ottermarine/pypilot_controller/pypilot_controller.kicad_pcb

## KiCad design pypilot_controller.kicad_pcb (2025-01-22)

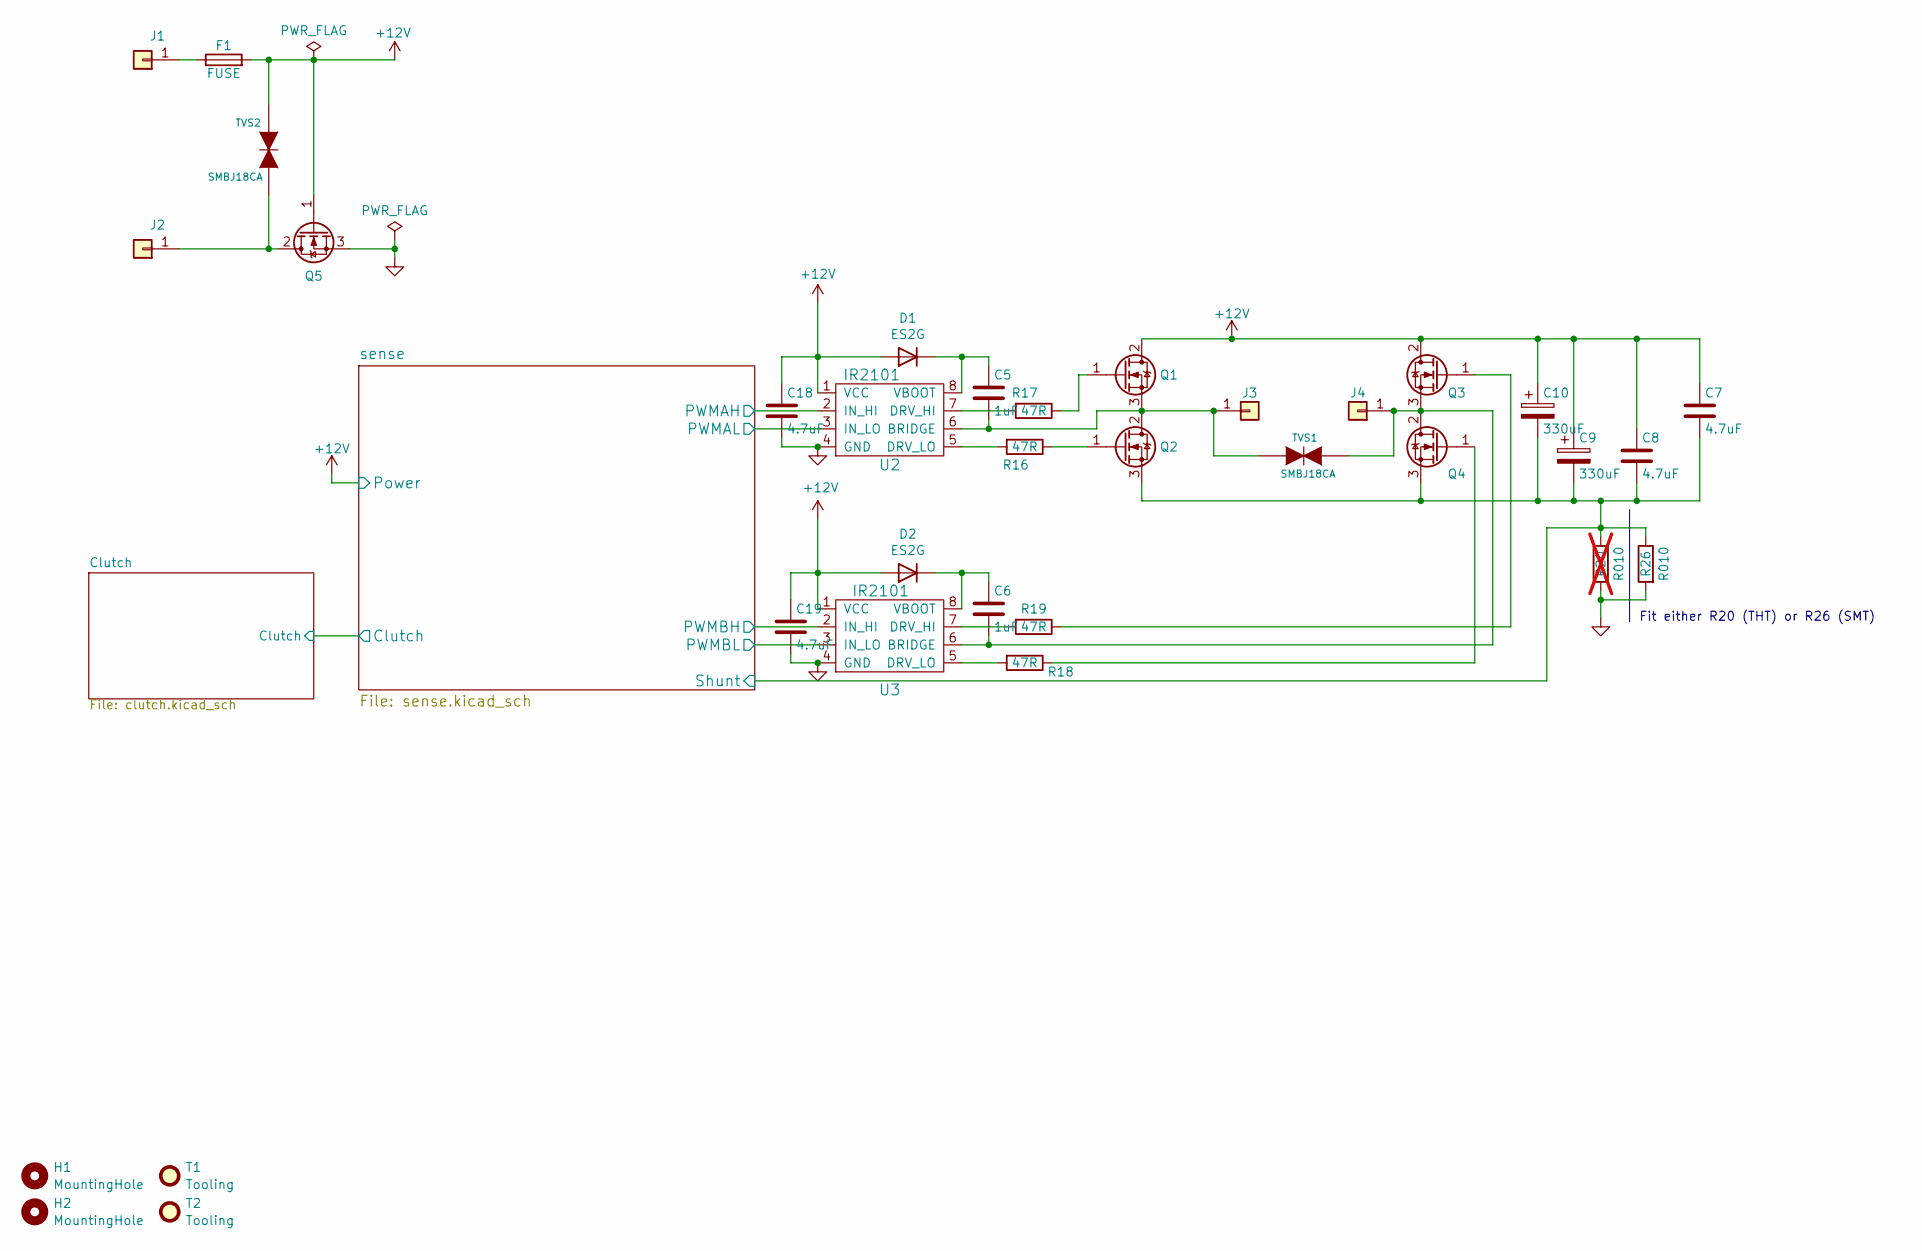
[picture p1: schematic pypilot_controller.kicad_sch]

Parts:
C5, C6: 1uF; C_0805_2012Metric; LCSC C28323
C7, C8, C18, C19: 4.7uF; C_1206_3216Metric; LCSC C29823
C9, C10: 330uF; CP_Radial_D10.0mm_P5.00mm; LCSC C357629
D1, D2: ES2G; D_SMA; LCSC C2848675
F1: FUSE; FUSE-TH_BX503-35; LCSC C2935871
H1, H2: MountingHole; MountingHole_2.5mm
J1: power+; CONN-TH_T44001; LCSC C481447
J2: power-; CONN-TH_T44001; LCSC C481447
J3: Motor A; CONN-TH_T44001; LCSC C481447
J4: Motor B; CONN-TH_T44001; LCSC C481447
Q1, Q2, Q3, Q4, Q5: IRFR7440; TO-252-2-reduced-paste; LCSC C97244
R16, R17, R18, R19: 47R; R_0805_2012Metric; LCSC C17714
R20: R010; R_Axial_DIN0207_L6.3mm_D2.5mm_P15.24mm_Horizontal; not fitted
R26: R010; R_2512_6332Metric; LCSC C105366
T1, T2: Tooling; JLC_Tooling_Hole
TVS1, TVS2: SMBJ18CA; D_SMB_TVS; LCSC C83327
U2, U3: IR2101; SOIC-8_3.9x4.9mm_P1.27mm; LCSC C2956

Connections:
+12V: C7.1, C8.1, C9.1, C10.1, C18.1, C19.1, D1.2 (A), D2.2 (A), F1.2, Q1.2 (D), Q3.2 (D), Q5.1 (G), TVS2.2 (K), U2.1 (VCC), U3.1 (VCC); also elsewhere on the board
/sense/PWMAH: U2.2 (IN_HI); also elsewhere on the board
/sense/PWMAL: U2.3 (IN_LO); also elsewhere on the board
/sense/PWMBH: U3.2 (IN_HI); also elsewhere on the board
/sense/PWMBL: U3.3 (IN_LO); also elsewhere on the board
/sense/Shunt: C7.2, C8.2, C9.2, C10.2, Q2.3 (S), Q4.3 (S), R20.1, R26.1; also elsewhere on the board
GND: C18.2, C19.2, Q5.3 (S), R20.2, R26.2, U2.4 (GND), U3.4 (GND); also elsewhere on the board
unnamed: C5.1, D1.1 (K), U2.8 (VBOOT)
unnamed: C6.1, D2.1 (K), U3.8 (VBOOT)
unnamed: F1.1, J1.1
unnamed: J2.1, Q5.2 (D), TVS2.1 (A)
unnamed: C5.2, J3.1, Q1.3 (S), Q2.2 (D), TVS1.2 (K), U2.6 (BRIDGE)
unnamed: C6.2, J4.1, Q3.3 (S), Q4.2 (D), TVS1.1 (A), U3.6 (BRIDGE)
unnamed: Q1.1 (G), R17.1
unnamed: Q2.1 (G), R16.1
unnamed: Q3.1 (G), R19.1
unnamed: Q4.1 (G), R18.1
unnamed: R17.2, U2.7 (DRV_HI)
unnamed: R16.2, U2.5 (DRV_LO)
unnamed: R19.2, U3.7 (DRV_HI)
unnamed: R18.2, U3.5 (DRV_LO)

Notes on the sheet:
Fit either R20 (THT) or R26 (SMT)

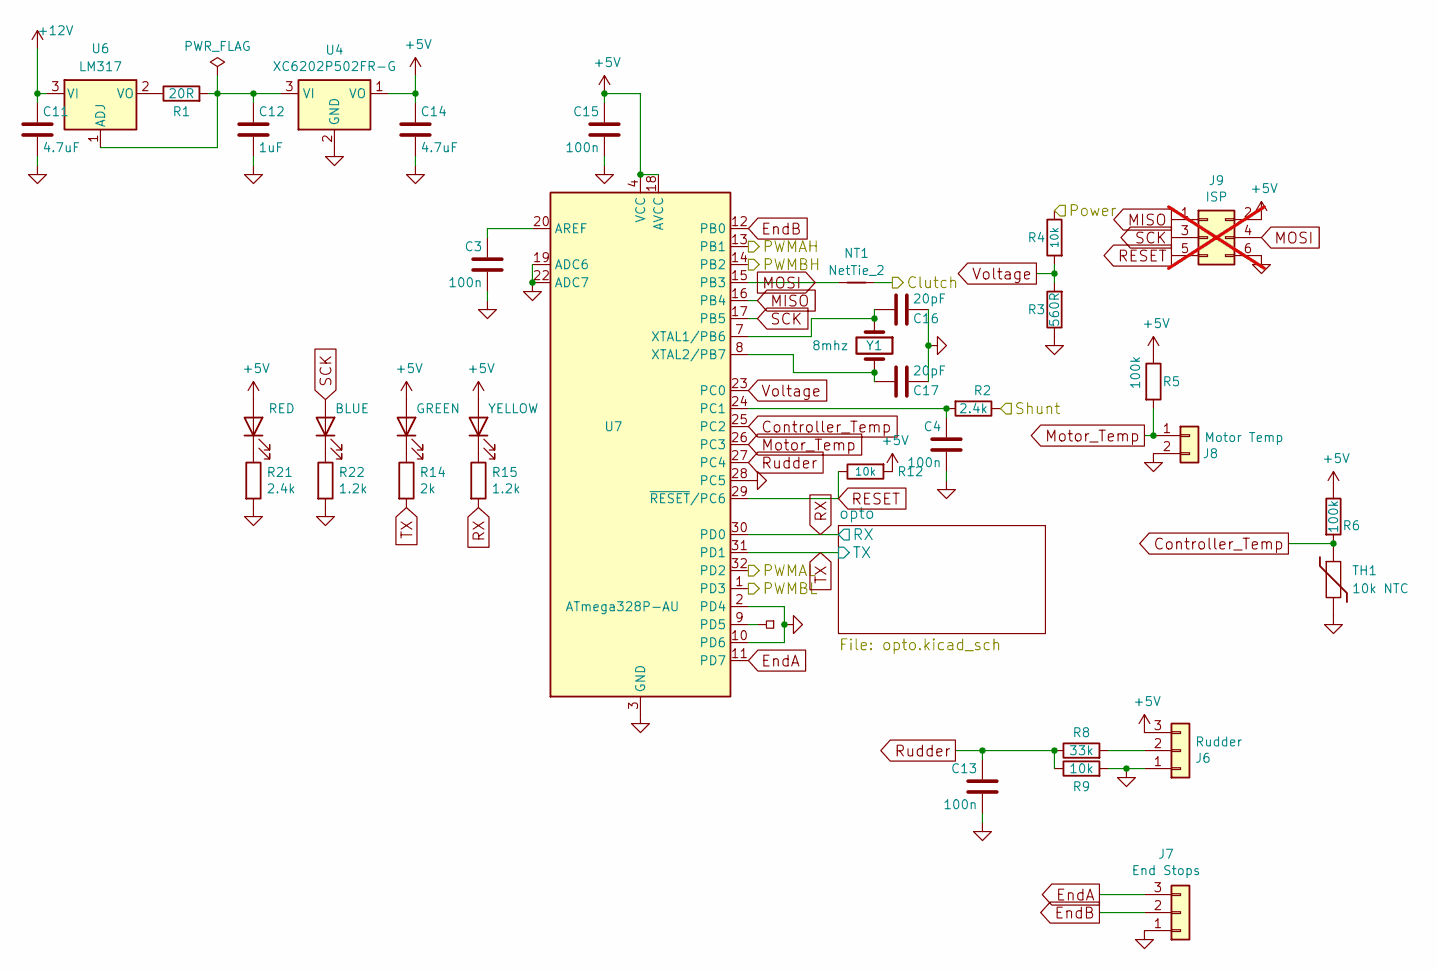
[picture p2: schematic sense.kicad_sch]

Parts:
C3, C4, C13, C15: 100n; C_0805_2012Metric; LCSC C49678
C11, C14: 4.7uF; C_1206_3216Metric; LCSC C29823
C12: 1uF; C_0805_2012Metric; LCSC C28323
C16, C17: 20pF; C_0805_2012Metric; LCSC C1798
J6: Rudder; PinHeader_1x03_P2.54mm_Vertical; LCSC C19190477
J7: End Stops; PinHeader_1x03_P2.54mm_Vertical; LCSC C19190477
J8: Motor Temp; PinHeader_1x02_P2.54mm_Vertical; LCSC C7494857
J9: ISP; PinHeader_2x03_P2.54mm_Vertical_SMD; LCSC C192301; not fitted
JP1: PCB_Pin_Breakout; TestPoint_Pad_1.0mm
LED1: RED; LED_0805_2012Metric; LCSC C84256
LED2: BLUE; LED_0603_1608Metric; LCSC C2290
LED3: GREEN; LED_0805_2012Metric; LCSC C2297
LED4: YELLOW; LED_0805_2012Metric; LCSC C2296
NT1: NetTie_2; NetTie-2_SMD_Pad0.5mm
R1: 20R; R_1206_3216Metric; LCSC C17955
R2, R21: 2.4k; R_0805_2012Metric; LCSC C17526
R3: 560R; R_0805_2012Metric; LCSC C28636
R4, R9, R12: 10k; R_0805_2012Metric; LCSC C17414
R5, R6: 100k; R_0805_2012Metric; LCSC C149504
R8: 33k; R_0805_2012Metric; LCSC C17633
R14: 2k; R_0805_2012Metric; LCSC C17604
R15, R22: 1.2k; R_0805_2012Metric; LCSC C17379
TH1: 10k NTC; R_0805_2012Metric; LCSC C72672
U4: XC6202P502FR-G; SOT-223-3_TabPin2; LCSC C725695
U6: LM317; TO-252-2-reduced-paste; LCSC C68136
U7: ATmega328P-AU; TQFP-32_7x7mm_P0.8mm; LCSC C14877
Y1: 8mhz; Crystal_SMD_5032-2Pin_5.0x3.2mm; LCSC C115962

Connections:
+5V: C14.1, C15.1, J6.3, J9.2, LED1.2 (A), LED3.2 (A), LED4.2 (A), R5.1, R6.1, R12.2, U4.1 (VO), U7.4 (VCC), U7.6 (VCC), U7.18 (AVCC); also elsewhere on the board
+12V: C11.1, R4.1, U6.3 (VI); also elsewhere on the board
/Clutch/Clutch: NT1.2; also elsewhere on the board
/sense/PWMAH: U7.13 (PB1); also elsewhere on the board
/sense/PWMAL: U7.32 (PD2); also elsewhere on the board
/sense/PWMBH: U7.14 (PB2); also elsewhere on the board
/sense/PWMBL: U7.1 (PD3); also elsewhere on the board
/sense/Shunt: R2.1; also elsewhere on the board
Controller_Temp: R6.2, TH1.1, U7.25 (PC2)
EndA: J7.3, U7.11 (PD7)
EndB: J7.2, U7.12 (PB0)
GND: C3.2, C4.2, C11.2, C12.2, C13.2, C14.2, C15.2, C16.1, C17.1, J6.1, J7.1, J8.2, J9.6, R3.1, R9.2, R21.2, R22.2, TH1.2, U4.2 (GND), U7.2 (PD4), U7.3 (GND), U7.5 (GND), U7.10 (PD6), U7.19 (ADC6), U7.21 (GND), U7.22 (ADC7), U7.28 (PC5); also elsewhere on the board
MISO: J9.1, U7.16 (PB4)
MOSI: J9.4, NT1.1, U7.15 (PB3)
Motor_Temp: J8.1, R5.2, U7.26 (PC3)
unnamed: J6.2, R8.2
unnamed: LED1.1 (K), R21.1
unnamed: LED2.1 (K), R22.1
unnamed: LED3.1 (K), R14.1
unnamed: LED4.1 (K), R15.1
unnamed: C12.1, R1.2, U4.3 (VI), U6.1 (ADJ)
unnamed: R1.1, U6.2 (VO)
unnamed: C3.1, U7.20 (AREF)
unnamed: C4.1, R2.2, U7.24 (PC1)
unnamed: JP1.1, U7.9 (PD5)
unnamed: C16.2, U7.7 (XTAL1/PB6), Y1.1
unnamed: C17.2, U7.8 (XTAL2/PB7), Y1.2
RESET: J9.5, R12.1, U7.29 (~RESET/PC6)
RX: R15.2, U7.30 (PD0); also elsewhere on the board
Rudder: C13.1, R8.1, R9.1, U7.27 (PC4)
SCK: J9.3, LED2.2 (A), U7.17 (PB5)
TX: R14.2, U7.31 (PD1); also elsewhere on the board
Voltage: R3.2, R4.2, U7.23 (PC0)

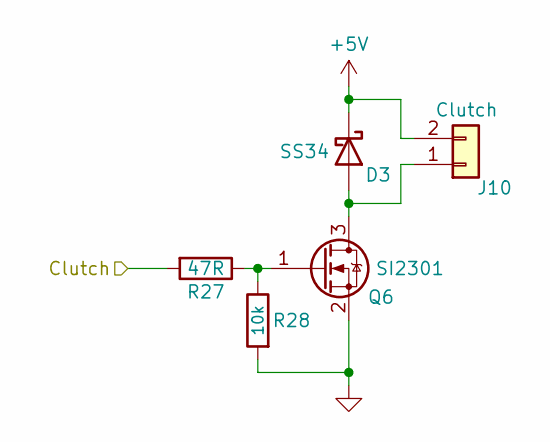
[picture p3: schematic clutch.kicad_sch]

Parts:
D3: SS34; D_SMA; LCSC C8678
J10: Clutch; PinHeader_1x02_P2.54mm_Vertical; LCSC C7494857
Q6: SI2301; SOT-23; LCSC C10487
R27: 47R; R_0805_2012Metric; LCSC C17714
R28: 10k; R_0805_2012Metric; LCSC C17414

Connections:
+5V: D3.1 (K), J10.2; also elsewhere on the board
/Clutch/Clutch: R27.2; also elsewhere on the board
GND: Q6.2 (S), R28.2; also elsewhere on the board
unnamed: D3.2 (A), J10.1, Q6.3 (D)
unnamed: Q6.1 (G), R27.1, R28.1

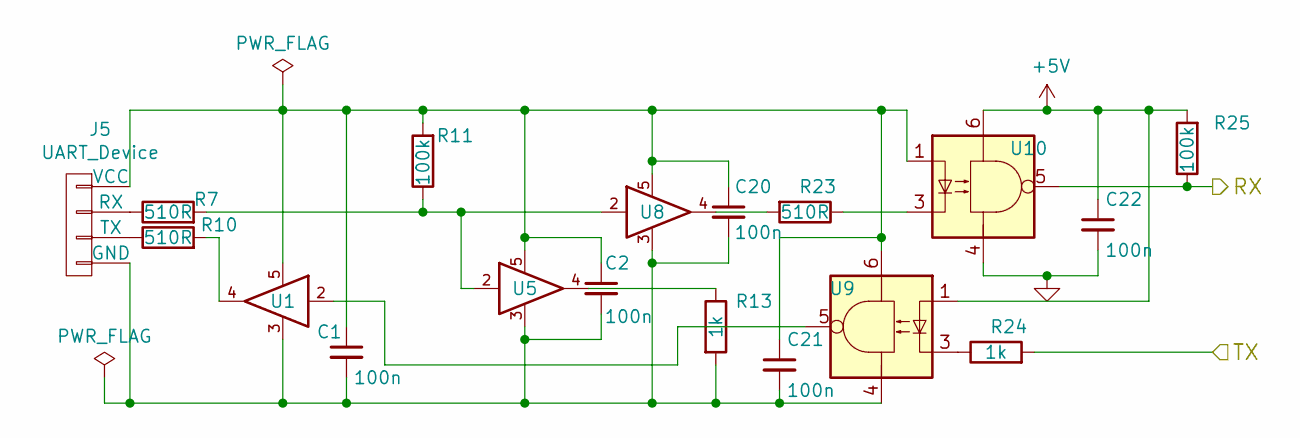
[picture p4: schematic opto.kicad_sch]

Parts:
C1, C2, C20, C21, C22: 100n; C_0805_2012Metric; LCSC C49678
J5: UART_Device; uart
R7, R10, R23: 510R; R_0805_2012Metric; LCSC C17734
R11, R25: 100k; R_0805_2012Metric; LCSC C149504
R13, R24: 1k; R_0805_2012Metric; LCSC C17513
U1, U5, U8: SN74LVC1G17DBVR; SOT-23-5; LCSC C7836
U9, U10: TLP2361(TPL,E(T; SO-5_4.4x3.6mm_P1.27mm; LCSC C107626

Connections:
+5V: C22.1, R25.2, U9.1, U10.6; also elsewhere on the board
GND: C22.2, U10.4; also elsewhere on the board
unnamed: C1.2, C2.2, C20.2, C21.2, J5.4 (GND), R13.2, U1.3, U5.3, U8.3, U9.4
unnamed: J5.2 (RX), R7.1
unnamed: J5.3 (TX), R10.1
unnamed: C1.1, C2.1, C20.1, C21.1, J5.1 (VCC), R11.2, U1.5, U5.5, U8.5, U9.6, U10.1
unnamed: R10.2, U1.4
unnamed: R7.2, R11.1, U5.2, U8.2
unnamed: R13.1, U5.4
unnamed: R23.1, U10.3
unnamed: R23.2, U8.4
unnamed: R24.1, U9.3
unnamed: U1.2, U9.5
RX: R25.1, U10.5; also elsewhere on the board
TX: R24.2; also elsewhere on the board

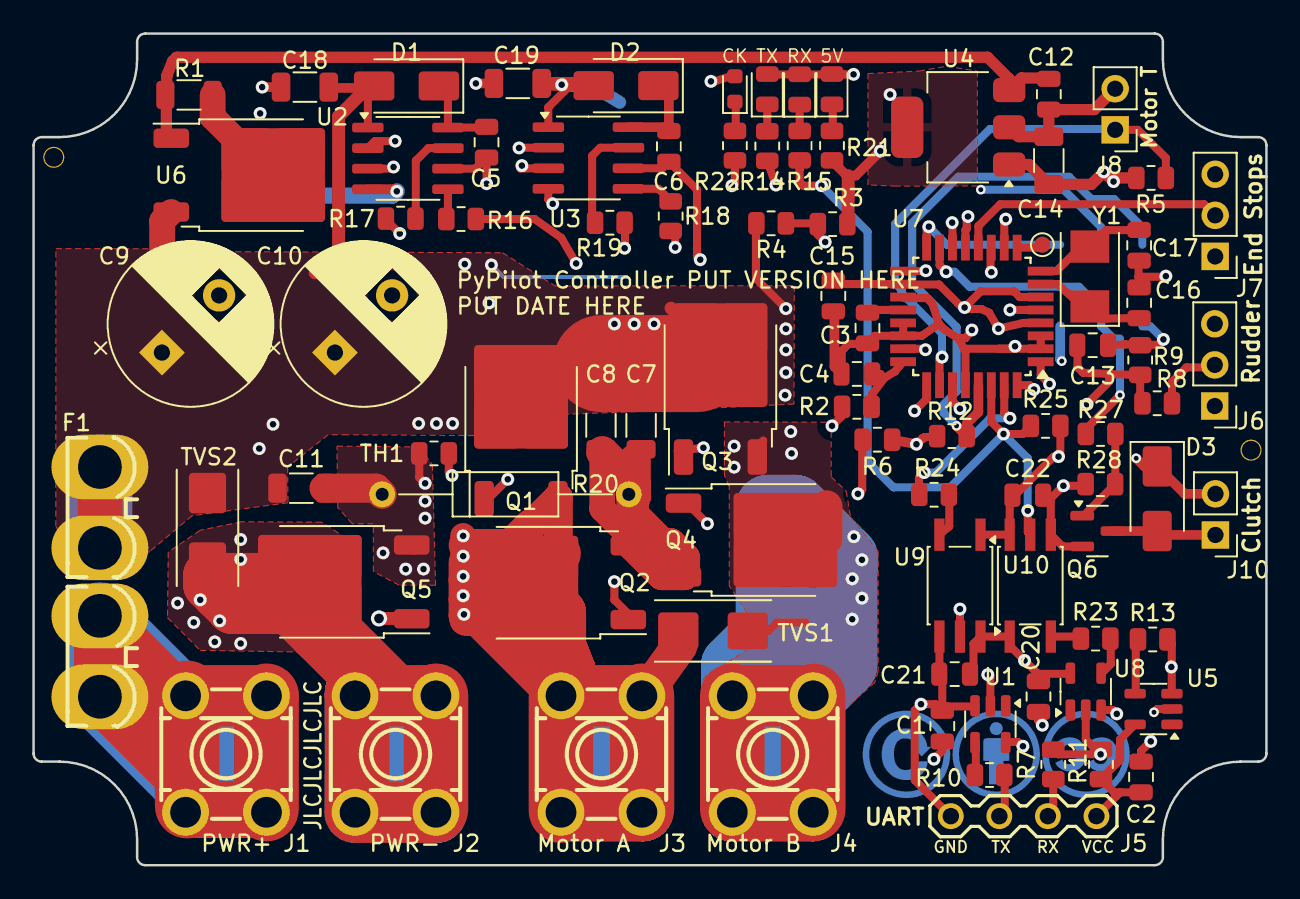
[picture p5: board pypilot_controller.kicad_pcb from above]

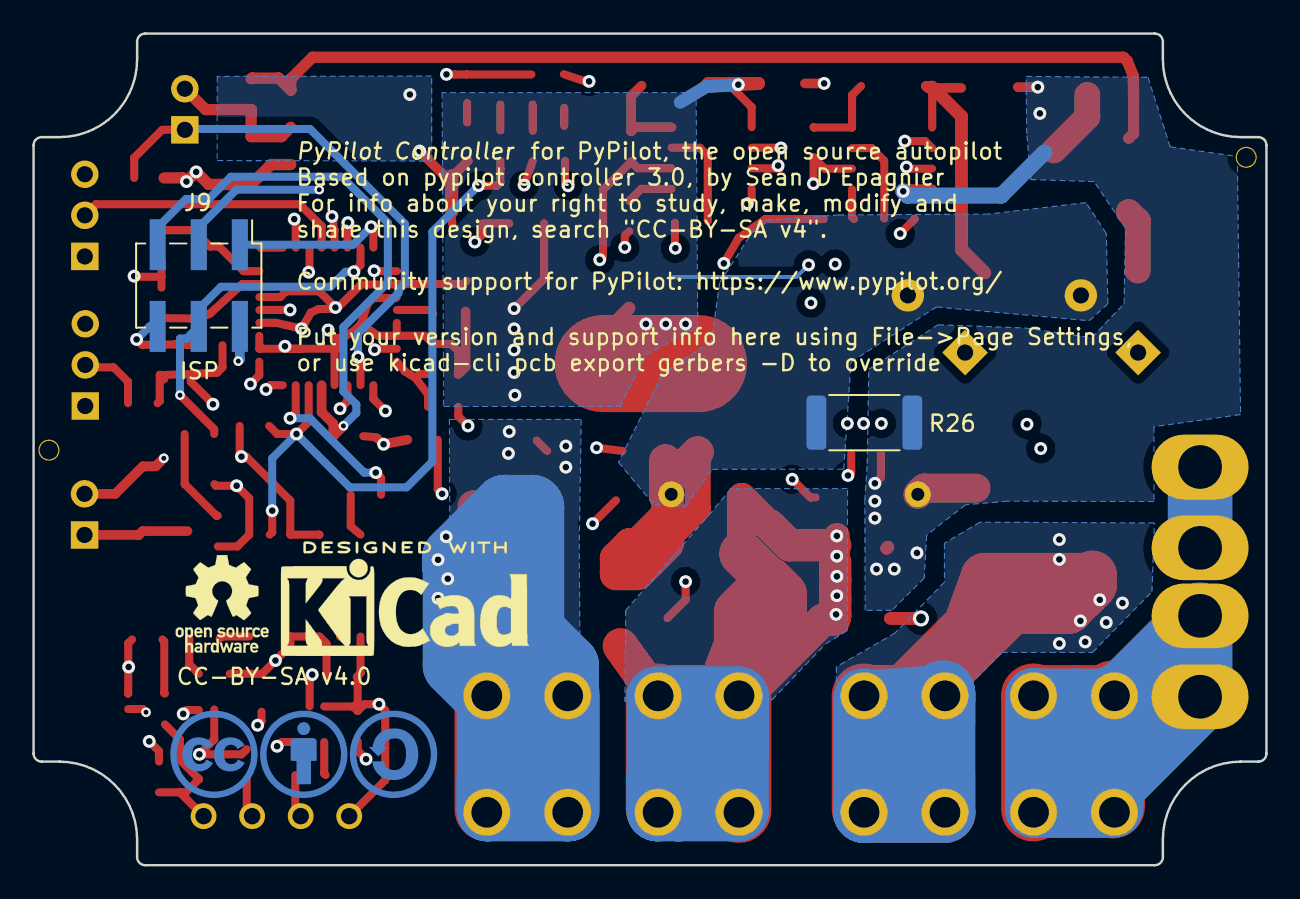
[picture p6: board pypilot_controller.kicad_pcb from below]

Board: 4 copper layers, 76.2 x 51.4 mm, 94 parts (3 on the bottom side), 60 nets.
