ottermarine/pypilot_controller/(commit log)

2024-12-04 Files as received from Sean
    [opto.sch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]
2024-12-04 Attempt to merge settings from .pro and .kicad_pro
2024-12-06 Provide missing freetronics_schematic and pypilot_components symbol libraries
    Recovered from pypilot_controller-rescue.kicad_sym, then converted to
    .kicad_sym format.
2024-12-06 Switch VCC to pypilot_controller symlib
    Because KiCad's VCC is an arrow, whereas the one that came with PyPilot
    is a circle. The VCC in pypilot_controller is the circle one.
    [pypilot_controller.sch]
2024-12-06 Switch to stock KiCad symbols that exist
    [sense.sch]
2024-12-06 Switch to new style local symbol libs
2024-12-06 Remove old sym lib with rescued symbols
    All symbols in use have been carefully crosschecked to KiCad's stock
    symbols for differences.
2024-12-06 UART connector sym lib converted to new format
2024-12-06 Replaced .sch schematics with new-style .kicad_sch equivalents
    [opto.kicad_sch, opto.sch, pypilot_controller.kicad_sch, pypilot_controller.sch, sense.kicad_sch, sense.sch]
2024-12-07 Fix tlp2631 symbol recommended footprint from Package_SO:SO-6 to Package_SO:SO-5
    [opto.kicad_sch]
2024-12-07 Switch footprints to stock KiCad versions, if the stock one is equivalent
    [opto.kicad_sch, pypilot_controller.kicad_pcb, pypilot_controller.kicad_sch, sense.kicad_sch]
2024-12-07 Move footprints into pypilot_controller_footprints, creating from PCB file if missing.
    [pypilot_controller.kicad_pcb, pypilot_controller.kicad_sch]
2024-12-07 Adjusted power pins on 74AHC1G125
    [opto.kicad_sch]
2024-12-07 Use stock KiCad symbols instead of Freetronics ones.
    [opto.kicad_sch, pypilot_controller.kicad_sch, sense.kicad_sch]
2024-12-07 Rearrangement to keep KiCad happy
    [pypilot_controller.kicad_sch]
2024-12-07 Move the UART header symbol from the uart sym lib to pypilot_components sym lib
    [opto.kicad_sch]
2024-12-07 Reconnect caps
    Stock symbols are smaller than the Freetronics ones were
    [pypilot_controller.kicad_sch, sense.kicad_sch]
2024-12-07 Patch in particular TVS model numbers
    [pypilot_controller.kicad_sch]
2024-12-08 First save of PCB with KiCad 8
    Gerbers are equivalent to originals
    [pypilot_controller.kicad_pcb]
2024-12-08 Removed fab layers
    In this day and age of PnP machines, it's just noise.
    [pypilot_controller.kicad_pcb]
2024-12-08 Replace 74AHC1G125 with 74LVC1G17
    [opto.kicad_sch, sense.kicad_sch]
2024-12-08 Fix symbol for ISP header
    [sense.kicad_sch]
2024-12-12 Add missing designators to schematic
    [opto.kicad_sch, sense.kicad_sch]
2024-12-12 Fix missing wires around smaller cap symbols
    [sense.kicad_sch]
2024-12-12 First pull of new footprints and net info from schematic to PCB
    It's obviously broken, many footprints aren't oriented or placed
    correctly
    [pypilot_controller.kicad_pcb]
2024-12-14 Rename old nets from KiCad 5 PCB to match net names coming from schematic in KiCad 8
    KiCad has changed its algorithm for naming nets.
    [pypilot_controller.kicad_pcb]
2024-12-14 Shifted MOSFET locations to match original board
    Centroid varies from original footprint
    [pypilot_controller.kicad_pcb]
2024-12-15 Fixed MOSFET positions
    New footprint has a different centroid
    [pypilot_controller.kicad_pcb]
2024-12-15 Updated UART footprint
    Esp the silk, and taking things off Eco1 layer
    [pypilot_controller.kicad_pcb]
2024-12-15 Update footprint on PCB for R20, the shunt resistor
    [pypilot_controller.kicad_pcb]
2024-12-15 Update footprint on PCB for R1, PSU ballast resistor
    [pypilot_controller.kicad_pcb]
2024-12-15 Update footprints for 0805 resistors on PCB
    [pypilot_controller.kicad_pcb]
2024-12-15 Remove silkscreen from screw terminal holes
2024-12-15 Remove silkscreen from footprint holes
2024-12-15 Update footprints on PCB for screw terminals, and fixed inconsistent alignment and track widths
    [pypilot_controller.kicad_pcb]
2024-12-15 Fix drill size I messed up
2024-12-15 Updated footprint on PCB for F1
    [pypilot_controller.kicad_pcb]
2024-12-15 Modified silkscreen of footprint to not be so wide
2024-12-15 Update footprint on PCB for TVS diodes
    [pypilot_controller.kicad_pcb]
2024-12-15 Update footprints on PCB for everything with a TO-252-2 footprint
    [pypilot_controller.kicad_pcb]
2024-12-15 Updated footprint on PCB for AMS1117
    [pypilot_controller.kicad_pcb]
2024-12-15 Update footprints on PCB for SOIC-8 gate drivers
    [pypilot_controller.kicad_pcb]
2024-12-15 Update footprints on PCB for SO-5 package optos.
    [pypilot_controller.kicad_pcb]
2024-12-15 Update footprint on PCB for TQFP-32 ATmega328P
    [pypilot_controller.kicad_pcb]
2024-12-15 Update footprints on PCB for 0805 LEDs
    [pypilot_controller.kicad_pcb]
2024-12-15 Update footprints on PCB for 0603 LED
    [pypilot_controller.kicad_pcb]
2024-12-15 Update footprints on PCB for gate driver charge pump SMA package diodes
    Expanded courtyard reqiured moving components a little
    [pypilot_controller.kicad_pcb]
2024-12-15 Updated symbol for ISP header
    Numbering was still set to old order
    [sense.kicad_sch]
2024-12-15 Updated footprint on PCB for ISP header
    [pypilot_controller.kicad_pcb]
2024-12-15 Add ES2G diode and XC6202P502FR-G 5V 200mA LDO regulator to symbols
2024-12-15 Switch the charge pump diode symbol that's actually being used
    [pypilot_controller.kicad_sch]
2024-12-15 Fixed pin number problem
2024-12-15 Switch from using AMS1117-5.0 to XC6202P502FR-G 5V 200mA LDO regulator
    This is what's in the CSV file as the regulator that's being used
    [pypilot_controller.kicad_sch, sense.kicad_sch]
2024-12-15 Oops, should hide datasheet and footprint fields in TVS symbol
2024-12-15 Update every symbol in the schematic
    [opto.kicad_sch, pypilot_controller.kicad_sch, sense.kicad_sch]
2024-12-15 Add a hidden pin 1, and move power pins so wires can be connected in schematic editor
2024-12-15 Rework the opto circuit with smaller caps to reduce clutter.
    [opto.kicad_sch]
2024-12-15 Pull from schematic, and update charge pump diodes, regulators and SOT-23-5 translators
    [pypilot_controller.kicad_pcb]
2024-12-15 Update footprints on PCB for headers
    [pypilot_controller.kicad_pcb]
2024-12-15 Fix a courtyard clearance problem
    [pypilot_controller.kicad_pcb]
2024-12-16 Update footprints on PCB for electrolytics
    [pypilot_controller.kicad_pcb]
2024-12-16 Update footprints on PCB for 1206 capacitors
    [pypilot_controller.kicad_pcb]
2024-12-16 Update footprints on PCB for 0805 caps
    [pypilot_controller.kicad_pcb]
2024-12-16 Update all symbols
    That it produced so little change confirms very little divergence from
    stock and custom symbols. Yippee!
    [opto.kicad_sch, pypilot_controller.kicad_sch]
2024-12-16 Changes KiCad keeps wanting to make to the project file
    Plus some from the original dump
2024-12-16 eeschema wants this line gone. Don't know why
    [opto.kicad_sch]
2024-12-16 Added a stack-up, plus some gerber settings
    [pypilot_controller.kicad_pcb]
2024-12-16 Added symbols for mounting and cable tie holes, to avoid warning on import from schematic
    [pypilot_controller.kicad_pcb, pypilot_controller.kicad_sch]
2024-12-16 Updated fuse footprint to have LCSC numbers
    [pypilot_controller.kicad_pcb]
2024-12-16 Refill zones
    And make a small tweak to add another thermal relief to ground zone
    [pypilot_controller.kicad_pcb]
2024-12-16 Added text to silkscreen on front and back with authorship, licence and websites
    [pypilot_controller.kicad_pcb]
2024-12-16 Switching to markdown format
2024-12-17 Moved some vias and silkscreen to make PyPilot Controller easier to read
    [pypilot_controller.kicad_pcb]
2024-12-17 Eeschema wants to move mounting holes in file
    [pypilot_controller.kicad_sch]
2024-12-17 Moved some wires to be clearer
    [pypilot_controller.kicad_sch]
2024-12-17 New part numbers from schematic import
    [pypilot_controller.kicad_pcb]
2024-12-17 Bump up size of version number in silkscreen
    [pypilot_controller.kicad_pcb]
2024-12-18 Remove whitespace from LCSC field entries
    [pypilot_controller.kicad_sch, sense.kicad_sch]
2024-12-18 Use standard format for resistor values
    [opto.kicad_sch, pypilot_controller.kicad_sch, sense.kicad_sch]
2024-12-18 Added version numbers to make variants easier to make
    [opto.kicad_sch, pypilot_controller.kicad_pcb, pypilot_controller.kicad_sch, sense.kicad_sch]
2024-12-18 Took my info out. This makes it easier for others to produce their own versions
    [pypilot_controller.kicad_pcb]
2024-12-19 Updating U9/U10 opto symbols pulled symbol into .kicad_sch file
    [opto.kicad_sch]
2024-12-19 Move hidden pin 1 to align to grid (removes ERC warning)
    [opto.kicad_sch]
2024-12-19 Import fixes to resistor values and LCSC part numbers from schematic
    [pypilot_controller.kicad_pcb]
2024-12-19 Move ISP header to the back of the board
    [pypilot_controller.kicad_pcb]
2024-12-22 pcbnew wants to move posn of ISP header in file
    [pypilot_controller.kicad_pcb]
2024-12-22 Add a surface mount shunt resistor to the back of the board
    [pypilot_controller.kicad_pcb, pypilot_controller.kicad_sch]
2024-12-22 Change license to CC-BY-SA v4.0
    [pypilot_controller.kicad_pcb]
2024-12-22 Reverted version number/date, because it can be scripted
    [pypilot_controller.kicad_pcb, pypilot_controller.kicad_sch]
2024-12-22 Added KiCad logo and CC license icons to back of PCB
    [pypilot_controller.kicad_pcb]
2024-12-22 C17 had LCSC part number for 12pF cap, but schematic says 18pF. Fixed.
    [sense.kicad_sch]
2024-12-22 Lock kicad/OSHW/CC graphics so they don't disappear on import from schematic
    [pypilot_controller.kicad_pcb]
2024-12-22 Update motor terminals to match silkscreen
    [pypilot_controller.kicad_sch]
2024-12-22 Pull from schematic
    [pypilot_controller.kicad_pcb]
2024-12-22 Replaced VCC symbol/net with +12V (otherwise there's an ERC warning)
    [pypilot_controller.kicad_sch]
2024-12-22 eeschema wants this cached copy of the tlp2361 gone
    [opto.kicad_sch]
2024-12-23 Turned off thermal relief for zone fills around the screw terminal
    (Fixes a problem where there was a gap in the copper near Motor B)
    [pypilot_controller.kicad_pcb]
2024-12-23 Break out PD5, pin 9 of ATmega328
    [pypilot_controller.kicad_pcb, pypilot_controller.kicad_sch, sense.kicad_sch]
2024-12-23 Added tooling holes for JLC's assembly service
    [pypilot_controller.kicad_pcb, pypilot_controller.kicad_sch]
2024-12-23 Added JLCJLCJLCJLC to silkscreen so JLC know where to put their production code
    [pypilot_controller.kicad_pcb]
2024-12-24 Unlock back of board graphics, but mark them as not in schematic to prevent removal
    [pypilot_controller.kicad_pcb]
2024-12-24 Break out clutch pin to header
    [pypilot_controller.kicad_pcb, pypilot_controller.kicad_sch]
2024-12-24 A no-op footprint refresh for the TO-252 parts
    A nop
    [pypilot_controller.kicad_pcb]
2024-12-24 Refresh of TO-252-2 footprints in prep for reduced paste version
    [pypilot_controller.kicad_pcb]
2024-12-24 Change TO-252 footprint to use less solder paste
    [opto.kicad_sch, pypilot_controller.kicad_pcb, pypilot_controller.kicad_sch, sense.kicad_sch]
2024-12-24 Cleaned up designators - where possible, they are all right way up
    [pypilot_controller.kicad_pcb]
2024-12-24 Added license tag and moved eye candy on reverse side around
    [pypilot_controller.kicad_pcb]
2024-12-24 Moved posn of RED on LED1 to align with others
    [sense.kicad_sch]
2024-12-24 Added reduced paste TO-252-2 footprint
2024-12-24 Fixed almost all ERC errors and warnings (now 0 errors, 3 warnings)
    [opto.kicad_sch, pypilot_controller.kicad_pcb, pypilot_controller.kicad_sch, sense.kicad_sch]
2024-12-24 Fixed up some net breakage caused by the on-copper graphics on the back
    [pypilot_controller.kicad_pcb]
2024-12-24 Removed as many DRC errors and warnings as I could
    [pypilot_controller.kicad_pcb, pypilot_controller.kicad_sch]
2024-12-24 Track cleanups, mostly from Tools -> Cleanup Tracks & Vias
    [pypilot_controller.kicad_pcb]
2024-12-24 Cleaned LCSC part numbers out of datasheet field (and renamed 0.1u to 100n)
    [opto.kicad_sch, pypilot_controller.kicad_pcb, pypilot_controller.kicad_sch, sense.kicad_sch]
2024-12-28 Replace crystal caps with a JLC PCBA basic part (20pF instead of 18pF)
    [sense.kicad_sch]
2024-12-28 Show motor temp on J8, the motor temp connector
    [sense.kicad_sch]
2024-12-28 Update TVS diodes to be cheapest of all the options Sean mentioned
    [pypilot_controller.kicad_sch]
2024-12-28 Import to pcb after refining component choice
    [pypilot_controller.kicad_pcb]
2024-12-28 Updated screw terminals from C238164 to C481447, much cheaper
    [pypilot_controller.kicad_pcb, pypilot_controller.kicad_sch]
2024-12-28 Update 3d model and footprint for fuse holder
    [pypilot_controller.kicad_pcb, pypilot_controller.kicad_sch]
2024-12-28 Move TVS
    [pypilot_controller.kicad_pcb]
2024-12-28 Fix zone around thermistor
    [pypilot_controller.kicad_pcb]
2024-12-28 Fixed posn of MOSFET designators
    [pypilot_controller.kicad_pcb]
2024-12-28 Put clutch components onto separate sheet
    [clutch.kicad_sch, pypilot_controller.kicad_pcb, pypilot_controller.kicad_sch]
2024-12-28 Add MOSFET to switch a relay on the clutch output
    [clutch.kicad_sch, pypilot_controller.kicad_pcb, sense.kicad_sch]
2024-12-28 Tweaks to hand-load components for current availability
    [clutch.kicad_sch, pypilot_controller.kicad_sch, sense.kicad_sch]
2025-01-04 Moved components away from isolation barrier
    [pypilot_controller.kicad_pcb]
2025-01-22 Added a missing track in the opto section (rx pullup resistor)
    [pypilot_controller.kicad_pcb]
2025-01-22 Changes from saving with KiCad 8.0.8
    [clutch.kicad_sch, opto.kicad_sch, sense.kicad_sch]
2025-01-22 Pull of component fields from schematic (mostly LCSC numbers)
    [pypilot_controller.kicad_pcb]
2025-01-22 Modify board outline to fit Daho 83X58X34 enclosure. Remove mounting holes and move components.
    [pypilot_controller.kicad_pcb, pypilot_controller.kicad_sch]
2025-01-22 Mark ISP connector as DNP, so it doesn't appear in STEP export
    [pypilot_controller.kicad_pcb, sense.kicad_sch]
2025-01-22 Change cable clamp holes to NPTH slots
    [pypilot_controller.kicad_pcb]
2025-01-22 Added results of fit test to components received from LCSC
    [clutch.kicad_sch, pypilot_controller.kicad_sch, sense.kicad_sch]
2025-01-22 Specify MOSFET
    [pypilot_controller.kicad_pcb, pypilot_controller.kicad_sch]
2025-01-22 Import fit test results from schematic
    [pypilot_controller.kicad_pcb]
2025-01-22 Stretch electrocap models to 20mm tall
    [pypilot_controller.kicad_pcb]
2025-01-22 Fatten slots for cable tie
    [pypilot_controller.kicad_pcb]
2025-01-22 More fit test results
    [clutch.kicad_sch, opto.kicad_sch, pypilot_controller.kicad_pcb, pypilot_controller.kicad_sch, sense.kicad_sch]
2025-01-22 Turn off thermal reliefs for J1-J4, to increase current capacity
    [pypilot_controller.kicad_pcb]
