ottermarine/pypilot_controller/(notices)

Notices in the files:
pypilot_controller.kicad_pcb:
For info about your right to study, make, modify and
share this design, search \"CC-BY-SA v4\".
